1Bitsy/1bitsy-1up/firmware/src/README.md

# README

This is the default firmware of the 1bitsy 1UP.

It's intended for the 1Bitsy 1UP retro inspired handheld game console.

## Board connections

*none required*
