1Bitsy/1bitsy-1up/hardware/NOTES.md

# Other Projects
* [Circuit Sword (RPi)](https://github.com/kiteretro/Circuit-Sword/wiki/GB-Original-Case-Mod-Guide)
* [uGame (ATSAMD21)](https://hackaday.io/project/27629-game)
* [Lameboy (ESP8266)](https://hackaday.io/project/26823-lameboy-another-esp12-handheld)

# Possible tact switch options
* If we use an existing industrial design we should consider using the original membrane switches
* If we work on a micro tiny board we should look into SKPMAPE010 from ALPS used also by uGame
