1Bitsy/1bitsy-1up/firmware/src/main.c

/*
 * This file is part of the 1Bitsy 1UP retro inspired game console project.
 *
 * Copyright (C) 2017 Bob Miller <kbob@jogger-egg.com>
 * Copyright (C) 2017 Piotr Esden-Tempski <piotr@esden.net>
 *
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
 * You should have received a copy of the GNU General Public License
 * along with this program.  If not, see <http://www.gnu.org/licenses/>.
 */

#include <stdbool.h>

#include <libopencm3/stm32/flash.h>
#include <libopencm3/stm32/i2c.h>
#include <libopencm3/stm32/rcc.h>
#include <libopencm3/stm32/gpio.h>

#include "button_boot.h"
#include "gamepad.h"
#include "touch.h"
#include "i2c.h"
#include "lcd.h"
#include "led.h"
#include "math-util.h"
#include "pam8019.h"
#include "volume.h"
#include "systick.h"
#include "text.h"

/* "Apps" */
#include "munch_app.h"
#include "tile_app.h"
#include "audio_app.h"
#include "fblocks_app.h"

#define MY_CLOCK (rcc_hse_25mhz_3v3[RCC_CLOCK_3V3_168MHZ])
#define BG_COLOR 0x0000         // black

uint32_t   fps;

enum app_ids {
    munch_app,
    tile_app,
    audio_app,
    fblocks_app,
    end_app
} active_app = munch_app;

/* Function pointers to available apps. The first one executes by default.
 * Do not forget to adjust the enum if you are messing around with this list.
 */
struct app {
	void (*init)(void);
	void (*animate)(void);
	void (*render)(void);
	void (*end)(void);
} apps[] = {
	[munch_app] = {
		.init = munch_init,
		.animate = munch_animate,
		.render = munch_render,
                .end = NULL,
	},
	[tile_app] = {
		.init = tile_init,
		.animate = tile_animate,
		.render = tile_render,
                .end = NULL,
	},
	[audio_app] = {
		.init = audio_app_init,
		.animate = audio_animate,
		.render = audio_render,
                .end = audio_app_end,
	},
	[fblocks_app] = {
		.init = fblocks_init,
		.animate = fblocks_animate,
		.render = fblocks_render,
                .end = NULL,
	},
};

static void handle_systick(uint32_t millis)
{
    button_pressed_debounce();
}

static void setup(void)
{
    rcc_clock_setup_hse_3v3(&MY_CLOCK);
    flash_prefetch_enable();
    flash_icache_enable();
    flash_dcache_enable();

    setup_systick(MY_CLOCK.ahb_frequency);
    register_systick_handler(handle_systick);

    led_init();

    lcd_set_bg_color(BG_COLOR, false);
    lcd_init();

    pam8019_init();

    text_init();

    gamepad_init();
    touch_init();

    /* Disabling debug outputs, as the audio repair board uses these pins.
     * At present (11/2017), the pins PC5 and PC13 are available for debug.
     */

    /* Raise ~SHUTDOWN to enable audio output. */
    pam8019_set_mode(PM_SHUTDOWN);
    // gpio_mode_setup(GPIOA, GPIO_MODE_OUTPUT, GPIO_PUPD_NONE, GPIO3);
    // gpio_set(GPIOA, GPIO3);
    // gpio_mode_setup(GPIOA, GPIO_MODE_INPUT, GPIO_PUPD_NONE, GPIO0);
}

static void calc_fps(void)
{
    static uint32_t next_time;
    static uint32_t frame_count;
    frame_count++;
    /* gpio_toggle(GPIOA, GPIO1); */
    if (system_millis >= next_time) {
        fps = frame_count;
        frame_count = 0;
        next_time += 1000;
    }
}

static void check_app_switch(void)
{
    static bool state = false;

    if (!state) {
        if (button_pressed_debounce()) {
            if (apps[active_app].end) {
                apps[active_app].end();
            }
            active_app++;
            if (active_app == end_app) {
                active_app = 0;
            }
            if (apps[active_app].init) {
                apps[active_app].init();
            }
            state = true;
            gpio_clear(GPIOA, GPIO8);
        }
    } else {
        if (button_released_debounce()) {
            state = false;
            gpio_set(GPIOA, GPIO8);
        }
    }
}

static void run(void)
{
    if (apps[active_app].init) {
        apps[active_app].init();
    }
    while (true) {
        apps[active_app].animate();
        apps[active_app].render();
        check_app_switch();
        calc_fps();
    }
}

int main(void)
{
    /* Launch the ROM DFU bootloader if the user button is pressed just after
     * reset.
     */
    button_boot();

    setup();
    run();
}
