1Bitsy/1bitsy-1up/(commit log)

2016-11-06 Initial commit.
    Contains preliminary schematic of the 1Bitsy 1UP.
    [1bitsy-1up.kicad_pcb, 1bitsy-1up.sch]
2016-11-06 Removed data pulldowns, added LCD CS pullup, added SDIO Card Detect pin on the 1bitsy.
    [1bitsy-1up.sch]
2017-06-18 Some minor updates of the schematic.
    [1bitsy-1up.sch]
2017-06-18 Using the new logical 50pin connector.
    The new "logical" 50pin lcd connector is bit clearer layed out. (based
    on adafruit symbol) also we added a few jumpers in case we use the same
    pinout lcd as adafruit and not the one from buydisplay. The buydisplay
    capacitive touch display uses a separate connector for the captouch
    sensor data lines.
    [1bitsy-1up.kicad_pcb, 1bitsy-1up.sch]
2017-06-18 Set the button footprint to the one of SKEY rubber switches.
    [1bitsy-1up.sch]
2017-06-18 Added corner radius dimension.
    [1bitsy-1up.kicad_pcb]
2017-06-18 Updated sheet legend blocks.
    [1bitsy-1up.kicad_pcb, 1bitsy-1up.sch]
2017-06-18 Assigned micro sd card slot footprint.
    [1bitsy-1up.sch]
2017-06-19 Added initial schematic for a headphone amp.
    [1bitsy-1up.sch]
2017-06-22 Added battery chargei & powerpath management circuit.
    [1bitsy-1up.sch]
2017-06-23 Added USB V+ pogopin pad. Finalized battery management circuit.
    The battery charging and management circuit will be using the USB V+
    coming from an SMD pad tapped off by a pogopin. The 1Bitsy will require
    a modification removing the diode connecting USB V+ to +5V net. The
    powerpath output of the charge and management chip is then connected to
    the +5V rail.
    [1bitsy-1up.sch]
2017-06-24 Keys are now connected through shift registers.
    To save some pins I decided to connect the buttons through a shift
    register in the style of NES/SNES controllers. I could not find an SPI
    interface on the STM32 that would offer MISO, NSS and SCK without
    colliding with some other feature of the 1UP.
    The final compromise I settled on is to connect SCK to SPI1MOSI and DO
    to SPI1MISO. We can either just bitbang the shift register shifting or
    send out alternating 01 patterns and read in 4 bits from the shift
    registers for every 8 bits shifted out. There might be some other more
    efficient hackery that could be done by starting a timer 50% duty cycle
    signal out to clock the shift registers and have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
    [1bitsy-1up.sch]
2017-06-24 Swapped out analog volume pot for a digital i2c pot.
    [1bitsy-1up.sch]
2017-06-25 Added volume up/down buttons.
    I wanted to use a thumbwheel encoder, but just like thumbwheel
    potentiometers they don't seem te be in production any more. (philips
    used to be the main manufacturer of those but they seem to have
    discontinued them) Decided to go with up down buttons instead. This
    helps us with not having to use up more of the 1Bitsy GPIO which is not
    bad.
    [1bitsy-1up.sch]
2017-06-25 Assigned footprints to all symbols.
    [1bitsy-1up.sch]
2017-06-25 Fixed the 1bitsy footprint. (used the version with too few pins)
    [1bitsy-1up.kicad_pcb, 1bitsy-1up.sch]
2017-06-25 Positioned and locked the gamepad buttons, audio jack, and power switch.
    [1bitsy-1up.kicad_pcb]
2017-06-26 Placed mechanical tft footprint. Some mechanical rearangement.
    Using the new mechanical tft drawing, I have placed the position of the
    TFT on the board. Using those references the 50pin and 6pin connectors
    found their positions. Also had to move the micro SD card slot as it was
    colliding with the 6pin capacitive touch socket. Added the cutout for
    the flatflex cable. Moved 1bitsy so that it does not interfere with the
    TFT. And updated PKL.
    [1bitsy-1up.kicad_pcb]
2017-06-26 Distributed passives to their respective active components & schematic fixes.
    Moved all the passives to the area where their active component circuits
    reside at the moment. The position of the subcircuits still can change
    and move.
    Also fixed the backlight mosfet circuit. (the sot23 pads were not
    connecting to the net because of a different pad naming scheme) Also
    found that the VCC of the lcd logic was not connected to power. DUH
    [1bitsy-1up.kicad_pcb, 1bitsy-1up.sch]
2017-06-28 Reoriented the keypad pullups to untangle ratsnest.
    [1bitsy-1up.kicad_pcb, 1bitsy-1up.sch]
2017-06-28 Updated SDCard footprint to get silkscreen art. Fixed SCL signal for touch.
    [1bitsy-1up.kicad_pcb, 1bitsy-1up.sch]
2017-06-28 Little mechanical cleanup. Added lanyard holes.
    [1bitsy-1up.kicad_pcb]
2017-06-28 Added some corner bling & started routing!~
    [1bitsy-1up.kicad_pcb]
2017-06-28 Routed SDCard & TFT video bus.
    [1bitsy-1up.kicad_pcb]
2017-06-29 Gamepad routed + some routing cleanup.
    [1bitsy-1up.kicad_pcb]
2017-06-29 Added 18650 battery holder.
    [1bitsy-1up.kicad_pcb, 1bitsy-1up.sch]
2017-06-29 Moved battery holder away from the gamepad. Removed decorative holes.
    [1bitsy-1up.kicad_pcb]
2017-06-29 Updated audio jack footprint, added the missing pcb edge cutout.
    [1bitsy-1up.kicad_pcb]
2017-06-29 Cleaned up gamepad routing.
    [1bitsy-1up.kicad_pcb]
2017-06-30 First routing pass finished!
    [1bitsy-1up.kicad_pcb, 1bitsy-1up.sch]
2017-06-30 Bunch of cleanups.
    Connected some qfn footprint thermal pads to ground. Cleaned up some
    routing.
    [1bitsy-1up.kicad_pcb, 1bitsy-1up.sch]
2017-06-30 More cleanup, resolved all DRC errors.
    [1bitsy-1up.kicad_pcb]
2017-06-30 Cleaned up the schematic a bit.
    [1bitsy-1up.sch]
2017-06-30 Added some decoupling caps.
    [1bitsy-1up.kicad_pcb, 1bitsy-1up.sch]
2017-06-30 Annotated the new caps.
    [1bitsy-1up.sch]
2017-06-30 Gerber output settings.
    [1bitsy-1up.kicad_pcb]
2017-06-30 Final version & Added backplate mounting holes, moved heart to mask layer.
    This is the final prototype version of the board. Submitted to OSHPark
    for production.
    A great suggestion from twitter, is to add a back plate to the board, to
    make that possible I have added a few more m3 mounting holes.
    When exporting gerber files I have found out that the pixel heart is not
    showing up, it turns out polygons do not work on silkscreen for some
    reason. (I bet it is some KiCad bug) Moved it back to solder stop layer
    again. (I have no problems with golden hearts! :D )
    [1bitsy-1up.kicad_pcb]
2017-06-30 Adjusted some resistor values.
    [1bitsy-1up.sch]
2017-07-04 Added dfu boot button.
2017-07-04 Some more remaining references to tiles replaced by slices.
    [gfx-pixslice.h, lcd.c, lcd.h]
2017-07-04 Added second app and switching using user button.
    Tile app is empty for now. But switching works.
2017-07-06 Changed lcd orientation to match hardware.
    We use the LCD in landscape mode, also I somehowe ended up mounting it
    up side down? o_O ... so we needed to tell the lcd to swap axis, and
    reverse drawing order on both axis. As a result we have the expected top
    to bottom and left to right pixel order for the data we are sending to
    the display. :D
    [lcd.c, lcd.h, munch_app.c, tile_app.c]
2017-07-06 Increase the LCD DMA data clock speed to 12mHz.
2017-07-08 Fix scrolling painting edge tiles.
    [tile_app.c]
2017-07-09 Output a frame pulse out on GPIOA1 pin.
    This way we can accurately check our framerate using a scope or LA.
2017-07-09 Add a framerate indicator.
    Prints the framerate in the right upper corner of the LCD. As a
    sideffect we got text rendering function. :D
2017-07-09 Added more gpio indicators.
    Now we have GPIOA3 indicate the time spent filling slices vs. GPIO1
    toggeling on each frame.
2017-07-09 Added gamepad driver.
    Added a bitbanging driver for the gamepad. When the gamepad is plugged
    in the animation routine freezes and moves the tilemap based on D-Pad
    input.
2017-07-15 Added more needed information for hardware assembly.
    Reorganized labels for placement plan and added part keys.
    [1bitsy-1up.kicad_pcb, 1bitsy-1up.sch]
2017-07-15 Increased size of the debug text again.
    The debug strings were really tiny, and when showing off the device
    people had trouble seeing them. :)
2017-07-15 Fixed gamepad code so it works with the actual hardware.
    The bit shifting was wrong anyways. Curious why it worked with the SNES
    controller at all. O_O
    [gamepad.c, gamepad.h]
2017-07-17 Initial commit of V0.2 of the board.
    Added voltage divider / battery voltage monitoring. It is connected to
    the battery management chip output to not leach the battery through the
    voltage divider while the system is off.
    [1bitsy-1up.kicad_pcb, 1bitsy-1up.sch]
2017-07-17 Simplidied the power on/off circuit.
    Just using a pullup and the switch pulls down. This way we need to only
    run one wire up to the top of the PCB.
    [1bitsy-1up.kicad_pcb, 1bitsy-1up.sch]
2017-07-17 Moved the battery voltage monitoring to the battery circuitry.
    It is now contained to one area it feels a little cleaner this way. The
    disadvantage is that now I have a longer additional sensing trace going
    from the bottom of the board. Things might change if I decide to
    compress all the circuitry onto a smaller subassembly.
    [1bitsy-1up.kicad_pcb]
2017-07-28 Fixed sprite tile rendering.
    [tile_app.c]
2017-08-04 Fixed LCD BL control.
    [lcd.c, lcd.h]
2017-10-01 Poll app button faster. Optimize OSD slightly.
2017-10-05 Fix audio_app to use LCD API correctly.
    [audio_app.c]
2018-02-20 Added 1Bitsy Samtec Connector names and links.
2018-02-20 Support PAM8019 control/status signals, control with button and LED.
2018-03-22 Re-enabled app switching.
2018-03-25 Fixed battery charge/management circuit.
    The SYSOFF pin is meant for disconnecting the battery from the system,
    but not for poweroff operation but for battery monitoring purposes. For
    example fuel gauge chip applications. The previous circuit wos
    preventing the 1UP from charging the battery while the system was
    powered off.
    While we were at it I also updated the schematic to KiCad V5.0.
    [1bitsy-1up.sch]
2018-03-29 Copied @kbob 1UP audio amplifier repair circuit.
    This new circuit is an improvevemnt over the previous design. Here are
    some highlights:
    * Different amplifier: PMA8019
    * Stereo speaker output. (we had only headphones before)
    * Potentiometer for volume control, instead of a digital pot.
    * Less parts in the path introducing audio skew and complexity.
    * Automatic switching between speaker output and headphone out.
    * Reading in the volume setting via STM32 ADC
    * Detecting headphones by monitoring the tip switch.
    [1bitsy-1up.sch]
2018-03-29 Add 1up-mini in contrib folder.
    This is like a 1bitsy-1up, but horizontal. It was designed to be easier
    to solder without 0402 or QFN.
    [1up-mini.kicad_pcb, 1up-mini.sch]
2018-03-29 Add touch screen driver.
2018-03-31 Connected the audio sense signals to the 1Bitsy.
    [1bitsy-1up.sch]
2018-03-31 Added STM32 symbol library.
2018-03-31 Added 1Bytsy schematic to the 1UP
    We are moving the whole 1Bitsy circuit directly onto the 1UP board to
    simplify things and get rid of the board interconnect.
    [1bitsy-1up.sch, 1bitsy.sch]
2018-04-01 Added FPGA. (iCEBreaker circuit, iCE40UP5k)
    The iCE40UP5k FPGA (mostly iCEBreaker-bitsy circuit) is now connected
    between the 1Bitsy STM32F415 mcu and the LCD. The default bitstream
    should pass the signals through resulting in transparent operation. This
    new FPGA will allow the transparent use of differet LCDs with different
    controllers than the ILI9341. It will also allow the implementation of
    FPGA based graphic accelerators and game emulators/implementations.
    Addition of the FPGA fabric into the mix will increase the amount of
    different interesting projects on this platform by a huge factor.
    Especially because the iCE40 can benefit from the open source Yosys,
    arachnepnr, icestorm toolchain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
    [1bitsy-1up.sch, 1bitsy.sch, icebreaker.sch]
2018-04-01 Added MEMS microphone input.
    [1bitsy-1up.sch, 1bitsy.sch, icebreaker.sch]
2018-04-01 Removed digital volume up/down buttons.
    [1bitsy-1up.sch]
2018-05-24 Added bit definitions for the gamepad buttons.
