1Bitsy/1bitsy-1up/(notices)

Notices in the files:
firmware/src/gpio.c:
This library is free software: you can redistribute it and/or modify
it under the terms of the GNU Lesser General Public License as published by
the Free Software Foundation, either version 3 of the License, or
(at your option) any later version.
firmware/src/fblocks_app.c:
This program is free software: you can redistribute it and/or modify
it under the terms of the GNU General Public License as published by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
hardware/contrib/1up-mini/1up-mini.kicad_pcb:
(C) 2017 1BitSquared LLC
License: CC-BY-SA V4.0
hardware/contrib/1up-mini/1up-mini.sch:
License: CC-BY-SA 4.0
hardware/v0.2/1bitsy.sch:
(C) 2016 1BitSquared LLC
